thotypous/telecom-p2-board/board/board.pdf

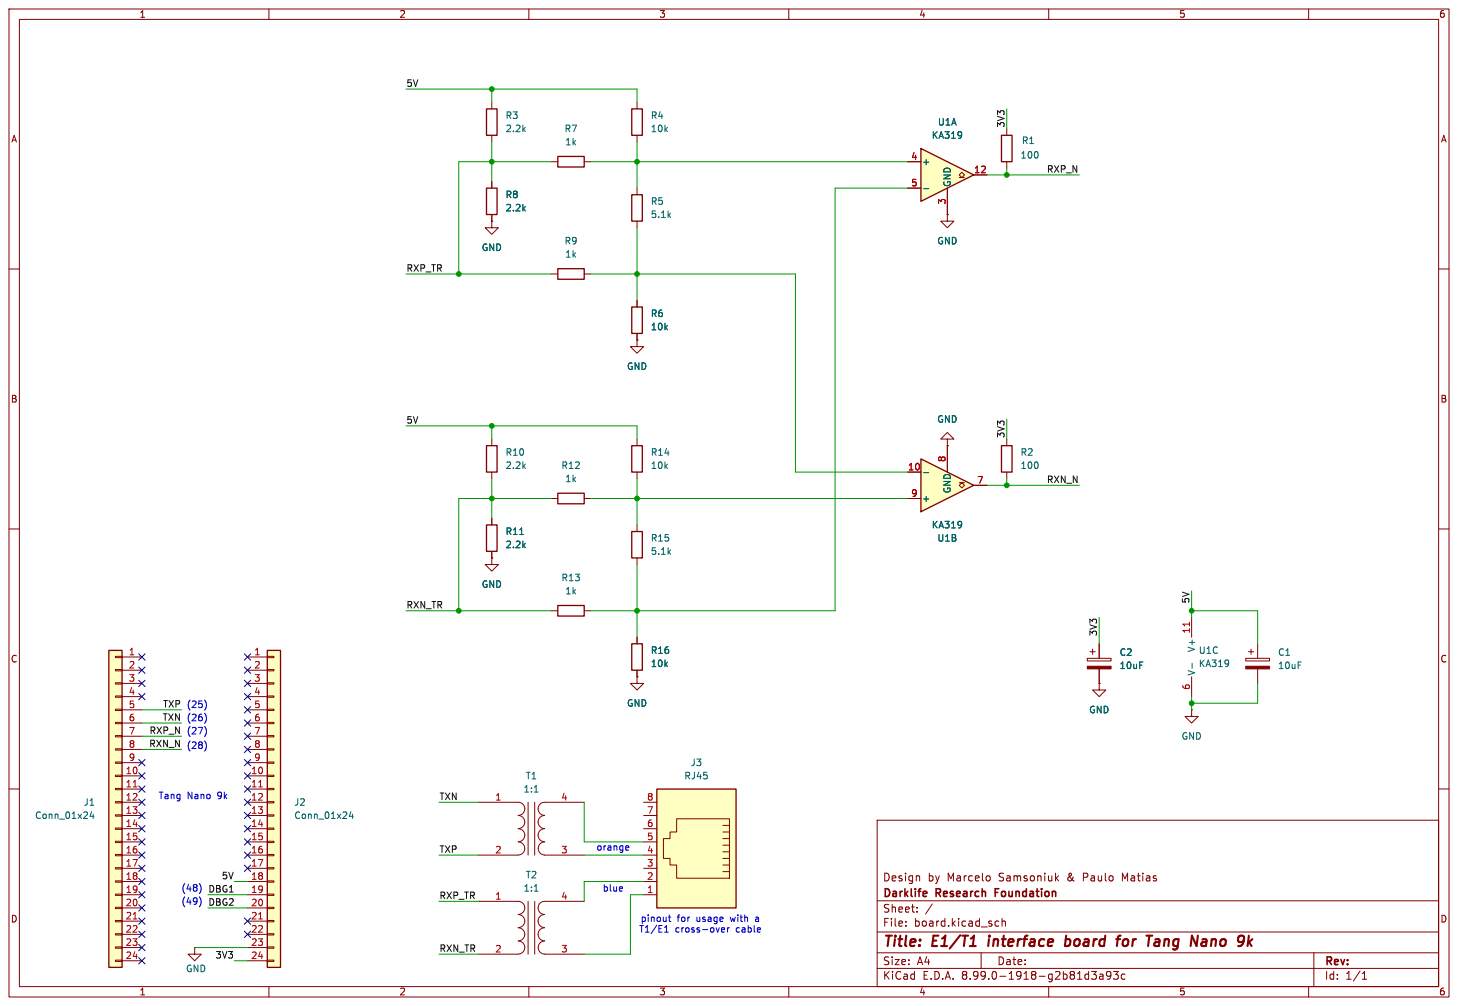
[picture p2: page 1]
