thotypous/telecom-p2-board/simulations/e1_t1_interface.asc

C3: cap; 100nF
C4: cap; 100nF
L1: ind2; 2mH
L2: ind2; 2mH
R1: res; 22
R2: res; 22
R3: res; 10k
R4: res; 10K
R5: res; 1k
R6: res; 1k
R7: res; 5k1
R8: res; 10K
R9: res; 5k1
R10: res; 1k
R11: res; 1k
R12: res; 10K
R13: res; 100
R14: res; 100
R15: res; 2k2
R16: res; 2k2
R17: res; 2k2
R18: res; 2k2
R19: res; 100
R20: res; 100
U1: LT1720
U3: LT1720
V1: voltage; PULSE(0 3.3V 0 0 0 240ns 488ns)
V2: voltage; PULSE(0 3.3V 366ns 0 0 240ns 488ns)
V3: voltage; 3.3V
Named nets: 0, RXN, RXP, RXP_TR, RXN_TR, RXP_P, RXP_N, RXN_P, RXN_N
.tran 0 10us 1us
K L1 L2 1
