thotypous/telecom-p2-board/board/board.kicad_sch

## KiCad design board/board.kicad_sch (2024-08-01)

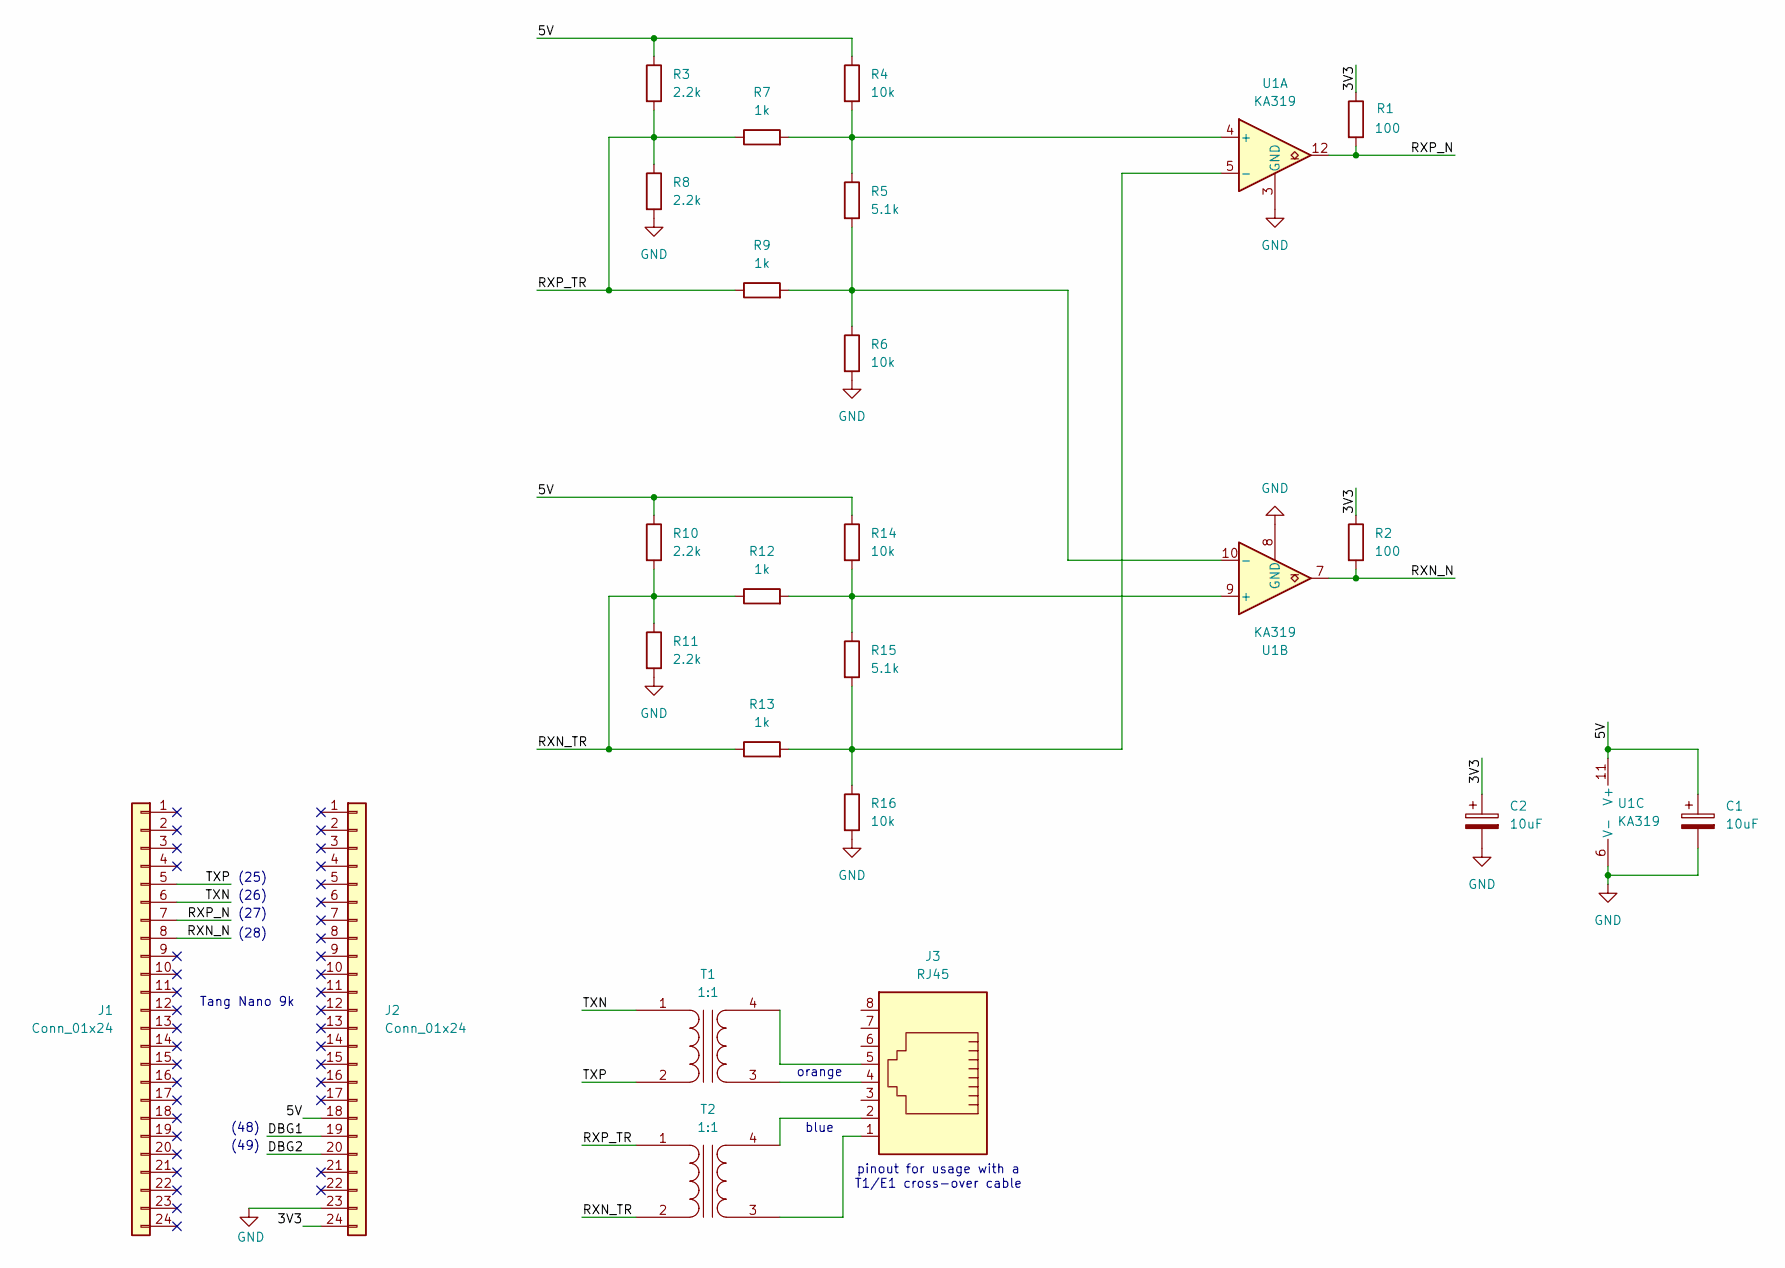
[picture p3: schematic board.kicad_sch]

Parts:
C1, C2: 10uF; CP_Elec_3x5.3
J1, J2: Conn_01x24; Molex_SL_171971-0024_1x24_P2.54mm_Vertical
J3: RJ45; RJ45_Amphenol_54602-x08_Horizontal
R1, R2: 100
R3, R8, R10, R11: 2.2k
R4, R6, R14, R16: 10k
R5, R15: 5.1k
R7, R9, R12, R13: 1k
T1, T2: 1:1
U1: KA319; DIP-14_W7.62mm_Socket

Connections:
3V3: C2.1, J2.24, R1.1, R2.1
5V: C1.1, J2.18, R3.1, R4.1, R10.1, R14.1, U1.11 (V+)
DBG1: J2.19
DBG2: J2.20
GND: C1.2, C2.2, J2.23, R6.2, R8.2, R11.2, R16.2, U1.3 (GND), U1.6 (V-), U1.8 (GND)
unnamed: J3.1, T2.3 (SA)
unnamed: J3.2, T2.4 (SB)
unnamed: J3.4, T1.3 (SA)
unnamed: J3.5, T1.4 (SB)
unnamed: R4.2, R5.1, R7.2, U1.4 (+)
unnamed: R5.2, R6.1, R9.2, U1.10 (-)
unnamed: R12.2, R14.2, R15.1, U1.9 (+)
unnamed: R13.2, R15.2, R16.1, U1.5 (-)
RXN_N: J1.8, R2.2, U1.7
RXN_TR: R10.2, R11.1, R12.1, R13.1, T2.2 (AB)
RXP_N: J1.7, R1.2, U1.12
RXP_TR: R3.2, R7.1, R8.1, R9.1, T2.1 (AA)
TXN: J1.6, T1.1 (AA)
TXP: J1.5, T1.2 (AB)

Notes on the sheet:
(48)
(49)
(27)
Tang Nano 9k
(26)
pinout for usage with a T1/E1 cross-over cable
(28)
blue
orange
(25)
